mttb-aarhustech/Motorcontrol_PCB/README.md

# Motorcontrol_PCB
Motorcontrol PCB AARHUS TECH
