mttb-aarhustech/Motorcontrol_PCB/Pins.txt

P1A			BC	RC2	
P1B			BC	RB2	
P1C			BC	RB1
P1D			BC	RB4

PGC			RB6	RB6
PGD			RB7	RB7
~MCLR			E	RE3

SWS	I/O			
SWA	I/O			
SWB	I/O			

AN0	Analog in 		
Vref-	RA2			RA2

T1CLK			AC	RC0

RX1			BC	RC7 -> RC6	x	
TX1			BC	RC6 -> RC7	x
BOOT	I/O			

DISP	I/O
SDO1			BC	RC5
SCK1			BC	RC3

SDA (i2c)		BC
SCL (i2c)		BC

SDO2			BC	
SDI2			BC
SCK2			BC
SS2			A

Fri

Icons
0xe,0x11,0x13,0x15,0x19,0x11,0xe,0x1f	0
0x4,0xc,0x4,0x4,0x4,0x4,0xe,0x1f	1
