mttb-aarhustech/Motorcontrol_PCB/Bom.xlsx

Sheet: BOM
Reference | Value | Qty | Supplier | Part number | Column1
Q111,Q113,Q121,Q123,Q132,Q142 | BC557 | 6 | Cypax | 01.020.0557 | 1
Q112,Q122,Q131,Q141,Q210,Q220,Q230,Q240 | BC547 | 8 | Farnell | 1574381 | 2
U901 | L78L05 | 1 | RS | 885-5423 | 3
C110,C120 | 2.2uF | 2 | Farnell | 8766797 | 4
J410 | Conn_01x06_Pin | 1 | - | - | 15
F1 | Fuse | 1 | Cypax | 18.099.0078.10 | 15
R403 | 100R | 1 | Cypax | 05.000.0510 | 15
R901 | 390 | 1 | Cypax | 05.000.0339 | 15
R902 | 68R | 1 | Cypax | 05.000.0268 | 15
C900 | 220uF | 1 | Farnell | 3254121 | 15
DS300 | WC1602A | 1 | Farnell | 1218634 | 15
J411 | USB_B | 1 | Farnell | 1076666 | 15
U410 | MCP2221AxP | 1 | Farnell | 2678459 | 15
U902 | HCPL7510 | 1 | Farnell | 1085055 | 15
J1,J4,J5,J6 | Conn_01x02_Socket | 1 | RS | 252-5139 | 15
J400 | Conn_01x05_Socket | 1 | RS | 233-9362 | 15
J401 | Conn_01x04_Socket | 1 | RS | 233-9354 | 15
L410 | Ferrite_Small | 1 | RS | 467-3315 | 15
R000 | 0R20 | 1 | RS | 846-9836 | 15
R301 | 20k | 1 | RS | 167-3259 | 15
SW310 | RotaryEncoder_Switch_MP | 1 | RS | 781-6830 | 15
U300 | 74AHC595 | 1 | RS | 100-0763 | 15
U400 | PIC18F27Q43-xSP | 1 | RS | 236-8940 | 15
U900 | LM317 | 1 | RS | 168-8786 | 15
 | Conn_01x04_Plug | 1 | RS | 252-5150 | 15
 | Conn_01x06_Socket | 1 | RS | 252-5144 | 15
 | Dil socket 28 pin | 1 | RS | 183-1570 | 15
 | Dil socket 16 pin | 1 | RS | 183-1561 | 15
 | Dil socket 14 pin | 1 | RS | 183-1562 | 15
 | Dil socket 8 pin | 1 | RS | 183-1560 | 15
R111,R121 | 47k | 2 | Cypax | 05.000.0547 | 30
R131,R141 | 270k | 2 | Cypax | 05.000.0627 | 30
R900,R903 | 3k3 | 2 | Cypax | 05.000.0433 | 30
C901,C902 | 10uF | 2 | Farnell | 2901339 | 30
 | Conn_01x02_Plug | 2 | RS | 252-5148 | 30
R110,R120,R130,R140 | 10R | 4 | Cypax | 05.000.0210 | 60
R112,R122,R132,R142 | 150R | 4 | Cypax | 05.000.0315 | 60
R210,R220,R230,R240 | 180 | 4 | Cypax | 05.000.0318 | 60
Q110,Q120,Q130,Q140 | IRLZ44N | 4 | Farnell | 8651418 | 60
U210,U220,U230,U240 | 4N35 | 4 | Farnell | 1021351 | 60
 | Dil socket 6 pin | 4 | RS | 702-0657 | 60
R211,R221,R231,R241,R251,R300,R310,R311,R312,R400,R401,R402,R410 | 10k | 13 | Cypax | 05.000.0510 | 195
R113,R114,R123,R124,R133,R143,R212,R222,R232,R242,R250,R313,R314,R315 | 1k | 14 | Cypax | 05.000.0410 | 210
Q112,Q122,Q131,Q141,Q210,Q220,Q230,Q240 | BC547 | 0 | Cypax | 01.020.0547
U400 | PIC18F27Q43-xSP | 0 | Farnell | 3052751
U410 | MCP2221AxP | 0 | RS | 171-7757
D110,D120,D900,D901 | 1N4148 | 4 | Cypax | 00.001.4148
C250,C300,C310,C311,C312,C400,C401,C411,C903,C904,C906,C907 | 100nF | ~12 | RS | 135-8304
C410 | 470nF | 1 | RS | 172-5820
C905 | 10nF | 1 | RS | 134-5708

Sheet: Sheet1
J401 |  | Conn_01x04_Socket | L410 |  | Ferrite_Small | R000 |  | 0R20
RS | 233-9354 |  | RS | 467-3315 |  | RS | 846-9836
SW310 |  | RotaryEncoder_Switch_MP | U300 |  | 74AHC595 | U900 |  | 10nF
RS | 781-6830 |  | RS | 100-0763 |  | RS | 134-5708
 |  | MCP2221AxP | U902 |  | 470nF |  |  | 100nF
RS | 171-7757 |  | RS | 172-5820 |  | RS | 135-8304
R210,R220,R230,R240 |  | 1N4148 |  |  | Dil socket 6 pin | R211,R221,R231,R241,R251,R300,R310,R311,R312,R400,R401,R402,R410 |  | 10k
Cypax | 00.001.4148 |  | RS | 702-0657 |  | Cypax | 05.000.0510
C901,C902 |  | Ferrite Small | R112,R122,R132,R142 |  | Rotary Encoder | PIC18F27Q43-xSP
Cypax | 05.000.0433 |  | Cypax | 05.000.0315 |  | Farnell | 3052751
47k |  |  | R131,R141 |  | Conn_01x05 Socket | R900,R903 |  | Conn_01x04 Socket
Cypax | 05.000.0547 |  | Cypax | 05.000.0627 |  | Cypax | 05.000.0433
