mttb-aarhustech/Motorcontrol_PCB/Motor Control.xlsx

Reference | Value | Qty | Supplier | Part number
F1 | Fuse | 1
J1,J4,J5,J6 | Conn_01x02_Socket | 4
J410 | Conn_01x06_Pin | 1
D110,D120,D900,D901 | 1N4148 | 4 | Cypax | 00.001.4148
Q111,Q113,Q121,Q123,Q132,Q142 | BC557 | 6 | Cypax | 01.020.0557
Q112,Q122,Q131,Q141,Q210,Q220,Q230,Q240 | BC547 | 8 | Cypax | 01.020.0547
R110,R120,R130,R140 | 10R | 4 | Cypax | 05.000.0210
R111,R121 | 47k | 2 | Cypax | 05.000.0547
R112,R122,R132,R142 | 150 | 4 | Cypax | 05.000.0315
R113,R114,R123,R124,R133,R143,R212,R222,R232,R242,R250,R313,R314,R315 | 1k | 14 | Cypax | 05.000.0410
R131,R141 | 270k | 2 | Cypax | 05.000.0627
R210,R220,R230,R240 | 180 | 4 | Cypax | 05.000.0318
R211,R221,R231,R241,R251,R310,R311,R312,R400,R401,R410 | 10k | 11 | Cypax | 05.000.0510
R900,R903 | 3k3 | 2 | Cypax | 05.000.0433
R901 | 390 | 1 | Cypax | 05.000.0339
R902 | 68R | 1 | Cypax | 05.000.0268
C110,C120 | 2.2uF | 2 | Farnell | 8766797
C900 | 220uF | 1 | Farnell | 3254121
C901,C902 | 10uF | 2 | Farnell | 2901339
DS300 | WC1602A | 1 | Farnell | 1218634
J411 | USB_B | 1 | Farnell | 1076666
Q110,Q120,Q130,Q140 | IRLZ44N | 4 | Farnell | 8651418
U210,U220,U230,U240 | 4N35 | 4 | Farnell | 1021351
U902 | HCPL7510 | 1 | Farnell | 1085055
C250,C300,C310,C311,C312,C400,C411,C903,C904,C906,C907 | 100nF | 11 | RS | 135-8304
C410 | 470nF | 1 | RS | 172-5820
C905 | 10nF | 1 | RS | 134-5708
J400 | Conn_01x05_Pin | 1 | RS | 233-9362
L410 | L_Ferrite_Small | 1 | RS | 467-3315
R000 | 0R20 | 1 | RS | 846-9836
R300 | 20k | 1 | RS | 167-3259
SW310 | RotaryEncoder_Switch_MP | 1 | RS | 781-6830
U300 | 74AHC595 | 1 | RS | 100-0763
U400 | PIC18F26K22-xSP | 1 | RS | 887-7252
U410 | MCP2221AxP | 1 | RS | 171-7757
U900 | LM317 | 1 | RS | 168-8786
U901 | L78L05 | 1 | RS | 885-5423
DIL fatninger
6 pin |  | 4 | RS | 813-109
8 pin |  | 1 | RS | 183-1560
14 pin |  | 1 | RS | 183-1562
16 pin |  | 1 | RS | 183-1561
28 pin |  | 1 | RS | 183-1570
Afstandsstykke |  | 4 | RS | 205-2945
Skrue |  | 4 | RS | 526-912
Møtrik |  | 4 | RS | 490-931
