mttb-aarhustech/Motorcontrol_PCB/Motor Control.pdf

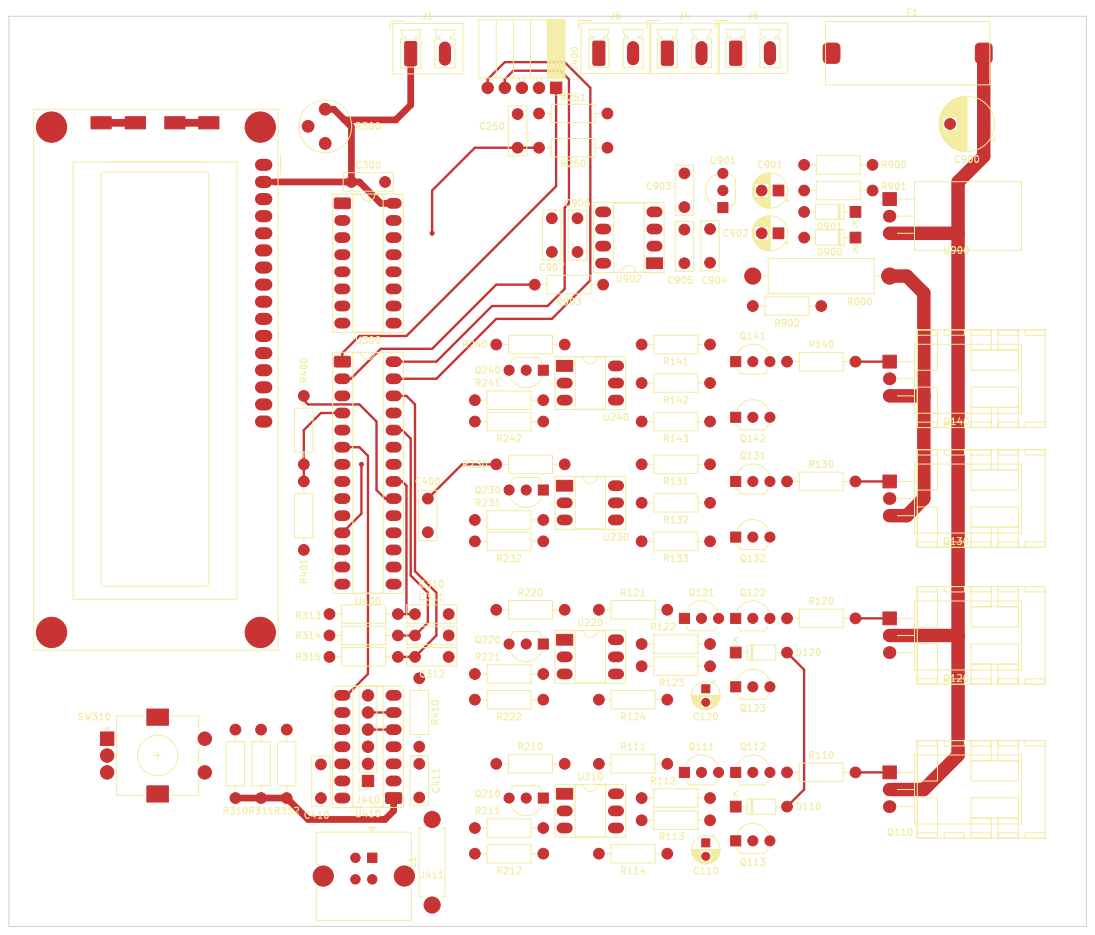
[picture p2: page 1]

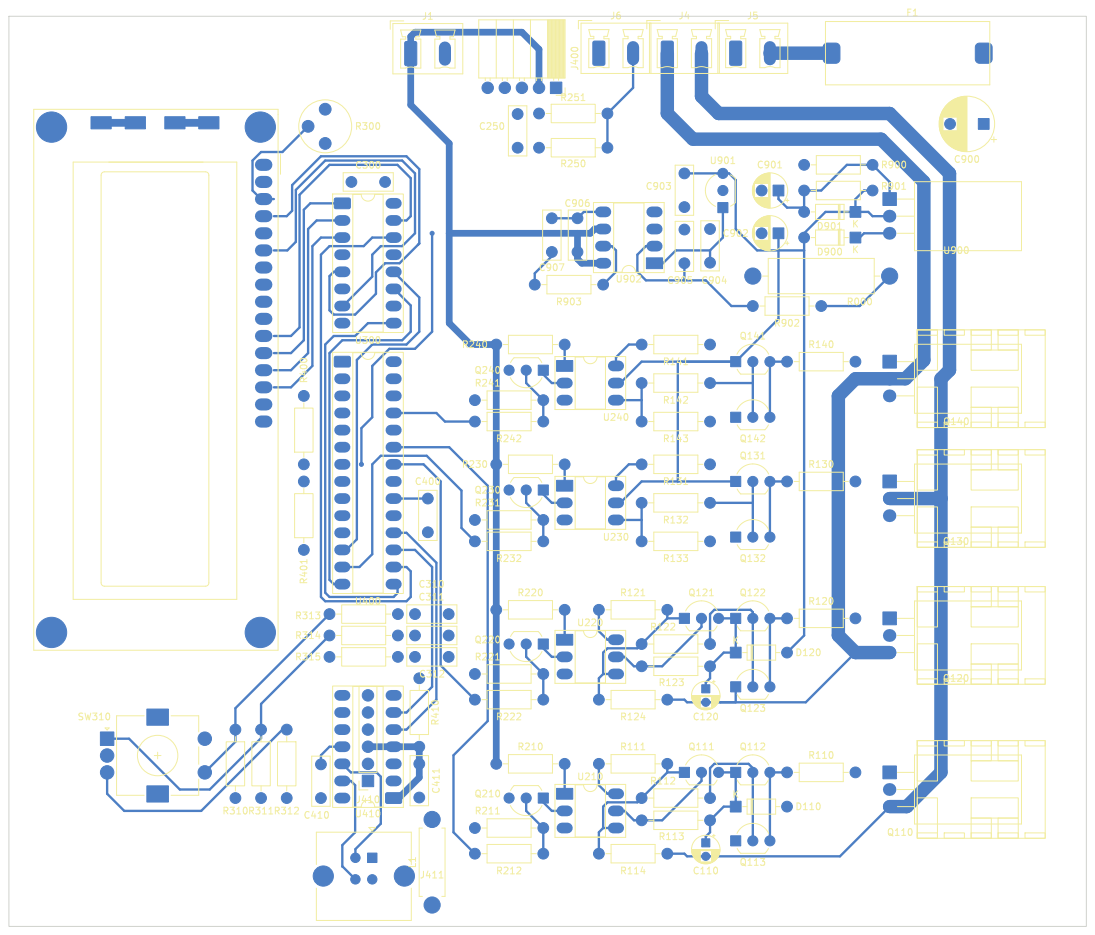
[picture p3: page 2]
