mttb-aarhustech/Motorcontrol_PCB/H_bridge/Motor Control-H Bridge.pdf

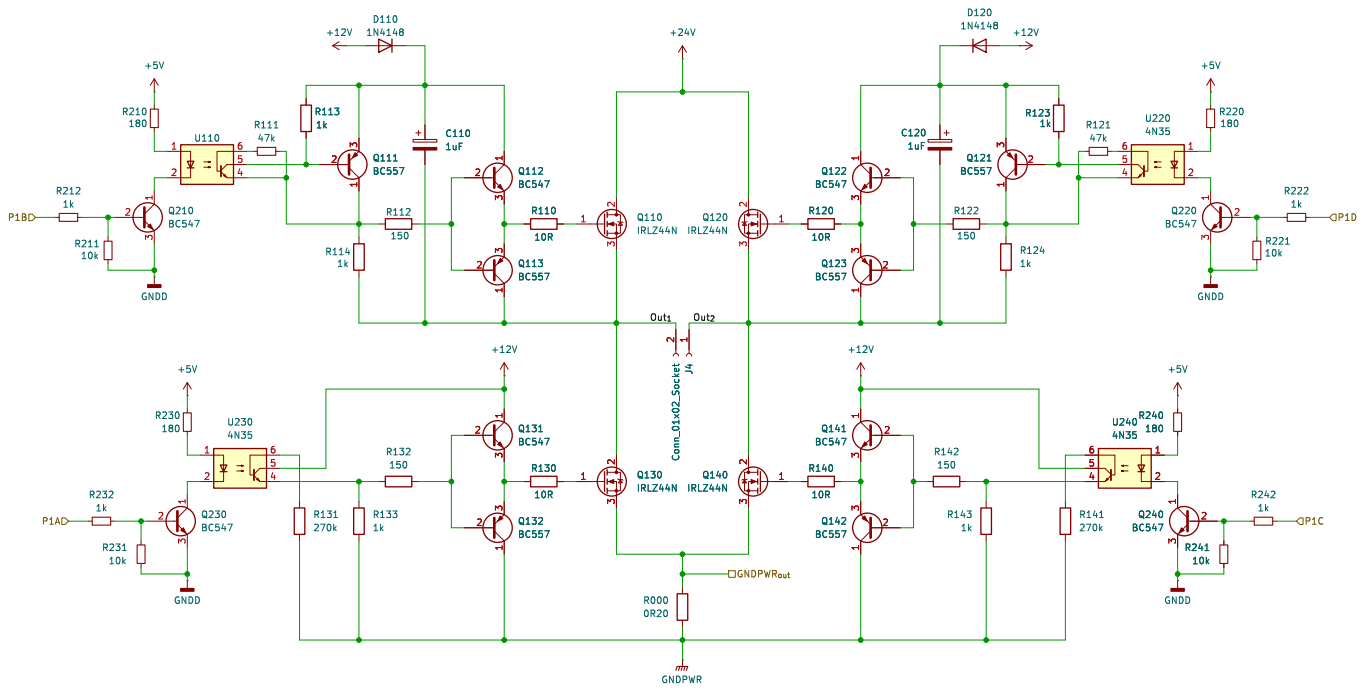
[picture p4: page 1]
