mttb-aarhustech/Motorcontrol_PCB/Motor Control.kicad_pcb

## KiCad design Motor Control.kicad_pcb (2025-12-16)

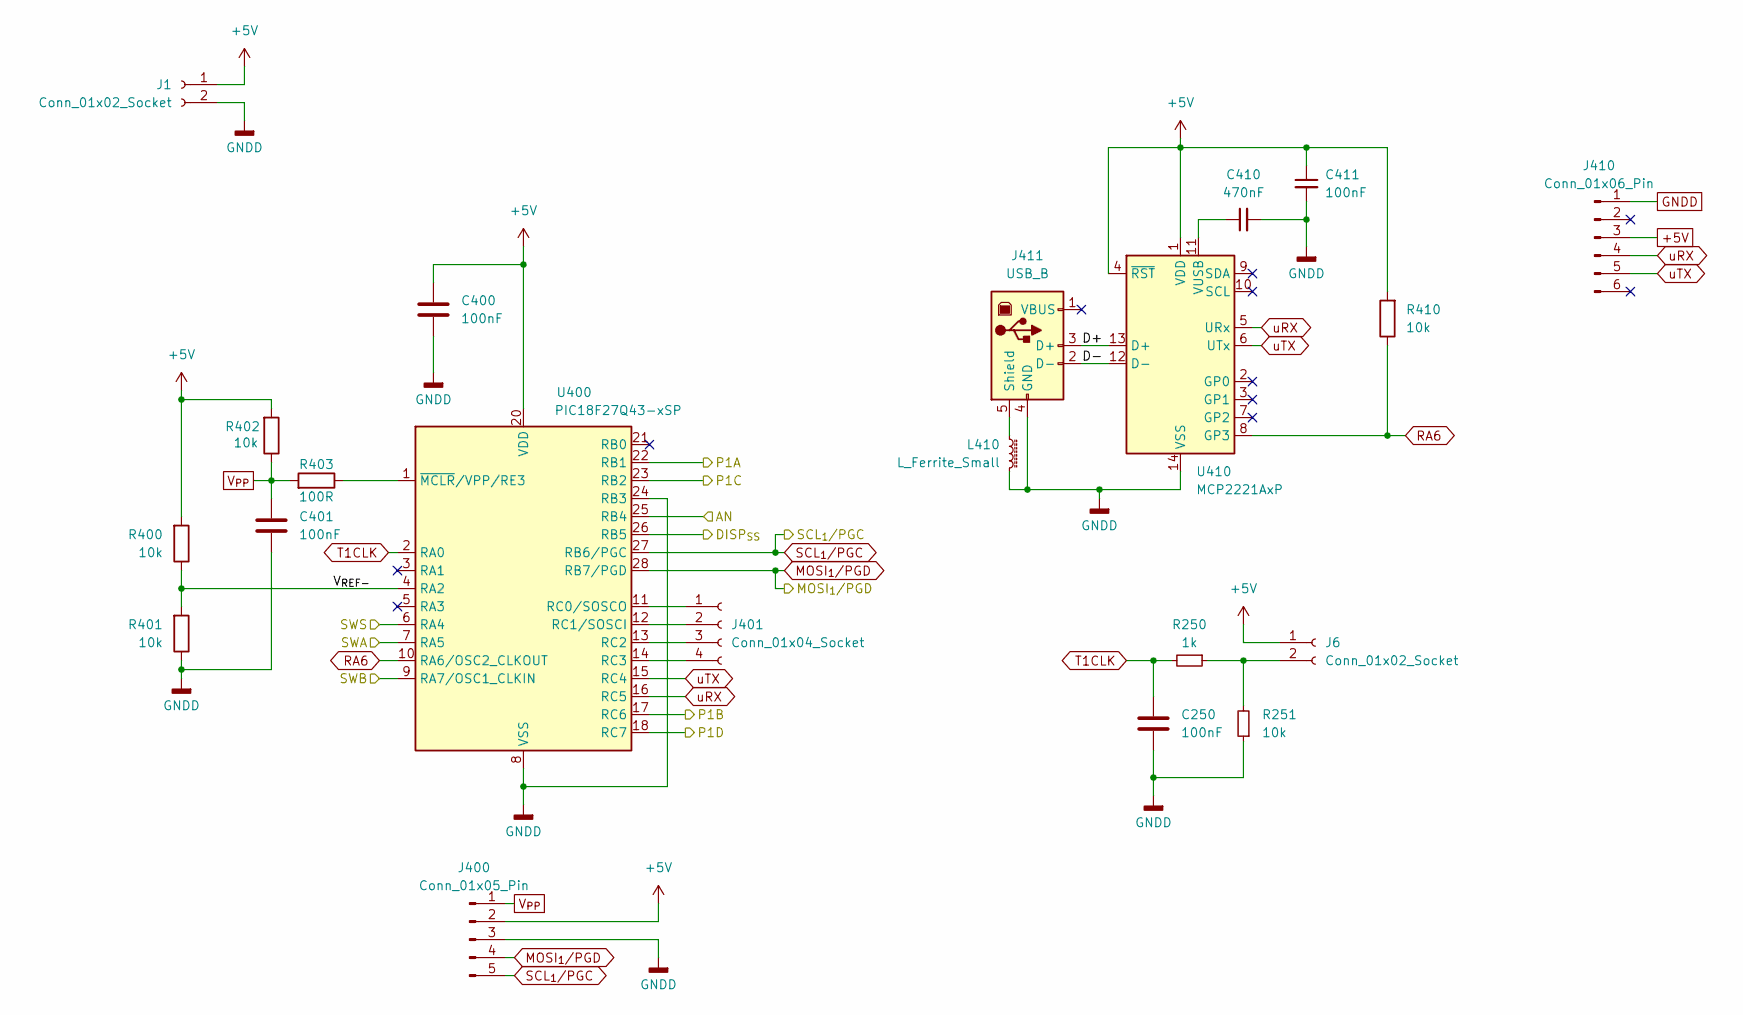
[picture p5: schematic MCU_USB.kicad_sch, Motor Control]

Parts:
C250, C400, C401, C411: 100nF; C_Rect_L7.2mm_W2.5mm_P5.00mm_FKS2_FKP2_MKS2_MKP2; Part number 135-8304
C410: 470nF; C_Rect_L7.2mm_W2.5mm_P5.00mm_FKS2_FKP2_MKS2_MKP2; Part number 172-5820
J1, J6: Conn_01x02_Socket; PhoenixContact_MCV_1,5_2-G-5.08_1x02_P5.08mm_Vertical
J400: Conn_01x05_Pin; PinSocket_1x05_P2.54mm_Horizontal; Part number 233-9362
J401: Conn_01x04_Socket; PinSocket_1x04_P2.54mm_Horizontal
J410: Conn_01x06_Pin; PinSocket_1x06_P2.54mm_Vertical
J411: USB_B; USB_B_TE_5787834_Vertical; Part number 1076666
L410: L_Ferrite_Small; R_Axial_DIN0411_L9.9mm_D3.6mm_P12.70mm_Horizontal; Part number 467-3315
R250: 1k; R_Axial_DIN0207_L6.3mm_D2.5mm_P10.16mm_Horizontal; Part number 05.000.0410
R251, R400, R401, R402, R410: 10k; R_Axial_DIN0207_L6.3mm_D2.5mm_P10.16mm_Horizontal; Part number 05.000.0510
R403: 100R; R_Axial_DIN0207_L6.3mm_D2.5mm_P10.16mm_Horizontal; Part number 05.000.0510
U400: PIC18F27Q43-xSP; DIP-28_W7.62mm_Socket_LongPads
U410: MCP2221AxP; DIP-14_W7.62mm_Socket_LongPads; Part number 171-7757

Connections:
+5V: C400.1, C411.1, J1.1, J6.1, J400.2, J410.3, R400.2, R402.2, R410.2, U400.20 (VDD), U410.1 (VDD), U410.4 (~RST); also elsewhere on the board
/Disp & encoder/DISP_{SS}: U400.26 (RB5); also elsewhere on the board
/Disp & encoder/SWA: U400.7 (RA5); also elsewhere on the board
/Disp & encoder/SWB: U400.9 (RA7/OSC1_CLKIN); also elsewhere on the board
/Disp & encoder/SWS: U400.6 (RA4); also elsewhere on the board
/H Bridge/P1A: U400.22 (RB1); also elsewhere on the board
/H Bridge/P1B: U400.17 (RC6); also elsewhere on the board
/H Bridge/P1C: U400.23 (RB2); also elsewhere on the board
/H Bridge/P1D: U400.18 (RC7); also elsewhere on the board
/MCU & USB/AN: U400.25 (RB4); also elsewhere on the board
/MCU & USB/D+: J411.3 (D+), U410.13 (D+)
/MCU & USB/D-: J411.2 (D-), U410.12 (D-)
/MCU & USB/V_{REF-}: R400.1, R401.2, U400.4 (RA2)
GNDD: C250.2, C400.2, C401.2, C410.2, C411.2, J1.2, J400.3, J410.1, J411.4 (GND), L410.2, R251.1, R401.1, U400.8 (VSS), U400.19 (VSS), U400.24 (RB3), U410.14 (VSS); also elsewhere on the board
MOSI_{1}/PGD: J400.4, U400.28 (RB7/PGD); also elsewhere on the board
unnamed: J6.2, R250.1, R251.2
unnamed: J401.1, U400.11 (RC0/SOSCO)
unnamed: J401.2, U400.12 (RC1/SOSCI)
unnamed: J401.3, U400.13 (RC2)
unnamed: J401.4, U400.14 (RC3)
unnamed: J411.5 (Shield), L410.1
unnamed: R403.1, U400.1 (~MCLR/VPP/RE3)
unnamed: C410.1, U410.11 (VUSB)
RA6: R410.1, U400.10 (RA6/OSC2_CLKOUT), U410.8 (GP3)
SCL_{1}/PGC: J400.5, U400.27 (RB6/PGC); also elsewhere on the board
T1CLK: C250.1, R250.2, U400.2 (RA0)
V_{PP}: C401.1, J400.1, R402.1, R403.2
uRX: J410.4, U400.16 (RC5), U410.5 (URx)
uTX: J410.5, U400.15 (RC4), U410.6 (UTx)

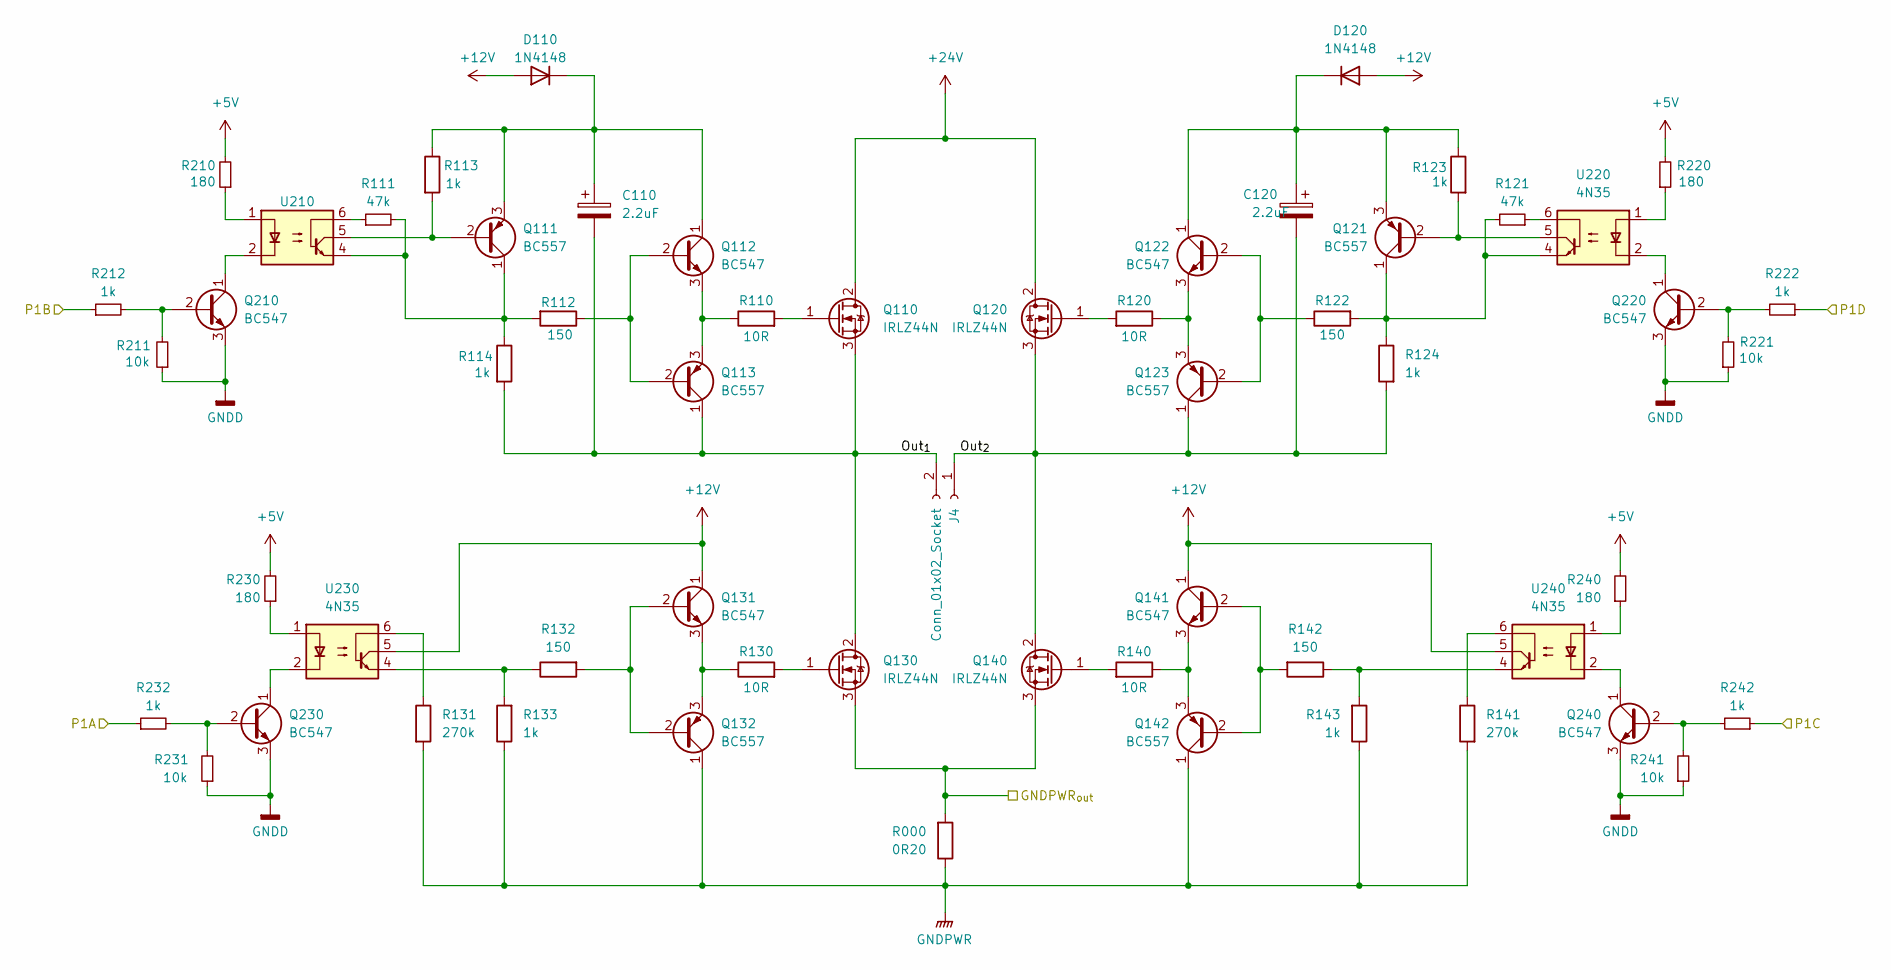
[picture p6: schematic H Bridge.kicad_sch, Motor Control]

Parts:
C110, C120: 2.2uF; CP_Radial_D4.0mm_P2.00mm; Part number 8766797
D110, D120: 1N4148; D_DO-35_SOD27_P7.62mm_Horizontal; Part number 00.001.4148
J4: Conn_01x02_Socket; PhoenixContact_MCV_1,5_2-G-5.08_1x02_P5.08mm_Vertical
Q110, Q120, Q130, Q140: IRLZ44N; TO-220-3_Horizontal_TabDown_HoleToCenter; Part number 8651418
Q111, Q113, Q121, Q123, Q132, Q142: BC557; TO-92_Inline_Wide; Part number 01.020.0557
Q112, Q122, Q131, Q141, Q210, Q220, Q230, Q240: BC547; TO-92_Inline_Wide; Part number 01.020.0547
R000: 0R20; R_Axial_DIN0516_L15.5mm_D5.0mm_P20.32mm_Horizontal; Part number 846-9836
R110, R120, R130, R140: 10R; R_Axial_DIN0207_L6.3mm_D2.5mm_P10.16mm_Horizontal; Part number 05.000.0210
R111, R121: 47k; R_Axial_DIN0207_L6.3mm_D2.5mm_P10.16mm_Horizontal; Part number 05.000.0547
R112, R122, R132, R142: 150; R_Axial_DIN0207_L6.3mm_D2.5mm_P10.16mm_Horizontal; Part number 05.000.0315
R113, R114, R123, R124, R133, R143, R212, R222, R232, R242: 1k; R_Axial_DIN0207_L6.3mm_D2.5mm_P10.16mm_Horizontal; Part number 05.000.0410
R131, R141: 270k; R_Axial_DIN0207_L6.3mm_D2.5mm_P10.16mm_Horizontal; Part number 05.000.0627
R210, R220, R230, R240: 180; R_Axial_DIN0207_L6.3mm_D2.5mm_P10.16mm_Horizontal; Part number 05.000.0318
R211, R221, R231, R241: 10k; R_Axial_DIN0207_L6.3mm_D2.5mm_P10.16mm_Horizontal; Part number 05.000.0510
U210, U220, U230, U240: 4N35; DIP-6_W7.62mm_Socket_LongPads; Part number 1021351

Connections:
+5V: R210.2, R220.2, R230.2, R240.2; also elsewhere on the board
+12V: D110.2 (A), D120.2 (A), Q131.1 (C), Q141.1 (C), U230.5, U240.5; also elsewhere on the board
+24V: Q110.2 (D), Q120.2 (D); also elsewhere on the board
/H Bridge/GNDPWR_{out}: Q130.3 (S), Q140.3 (S), R000.2; also elsewhere on the board
/H Bridge/Out_{1}: C110.2, J4.2, Q110.3 (S), Q113.1 (C), Q130.2 (D), R114.2
/H Bridge/Out_{2}: C120.2, J4.1, Q120.3 (S), Q123.1 (C), Q140.2 (D), R124.2
/H Bridge/P1A: R232.1; also elsewhere on the board
/H Bridge/P1B: R212.1; also elsewhere on the board
/H Bridge/P1C: R242.1; also elsewhere on the board
/H Bridge/P1D: R222.1; also elsewhere on the board
GNDD: Q210.3 (E), Q220.3 (E), Q230.3 (E), Q240.3 (E), R211.1, R221.1, R231.1, R241.1; also elsewhere on the board
GNDPWR: Q132.1 (C), Q142.1 (C), R000.1, R131.2, R133.1, R141.2, R143.1; also elsewhere on the board
unnamed: C110.1, D110.1 (K), Q111.3 (E), Q112.1 (C), R113.1
unnamed: C120.1, D120.1 (K), Q121.3 (E), Q122.1 (C), R123.1
unnamed: Q110.1 (G), R110.2
unnamed: Q111.2 (B), R113.2, U210.5
unnamed: Q111.1 (C), R111.2, R112.2, R114.1, U210.4
unnamed: Q112.2 (B), Q113.2 (B), R112.1
unnamed: Q112.3 (E), Q113.3 (E), R110.1
unnamed: Q120.1 (G), R120.2
unnamed: Q121.2 (B), R123.2, U220.5
unnamed: Q121.1 (C), R121.2, R122.2, R124.1, U220.4
unnamed: Q122.2 (B), Q123.2 (B), R122.1
unnamed: Q122.3 (E), Q123.3 (E), R120.1
unnamed: Q130.1 (G), R130.2
unnamed: Q131.2 (B), Q132.2 (B), R132.2
unnamed: Q131.3 (E), Q132.3 (E), R130.1
unnamed: Q140.1 (G), R140.2
unnamed: Q141.2 (B), Q142.2 (B), R142.2
unnamed: Q141.3 (E), Q142.3 (E), R140.1
unnamed: Q210.2 (B), R211.2, R212.2
unnamed: Q210.1 (C), U210.2
unnamed: Q220.2 (B), R221.2, R222.2
unnamed: Q220.1 (C), U220.2
unnamed: Q230.2 (B), R231.2, R232.2
unnamed: Q230.1 (C), U230.2
unnamed: Q240.2 (B), R241.2, R242.2
unnamed: Q240.1 (C), U240.2
unnamed: R111.1, U210.6
unnamed: R121.1, U220.6
unnamed: R131.1, U230.6
unnamed: R132.1, R133.2, U230.4
unnamed: R141.1, U240.6
unnamed: R142.1, R143.2, U240.4
unnamed: R210.1, U210.1
unnamed: R220.1, U220.1
unnamed: R230.1, U230.1
unnamed: R240.1, U240.1

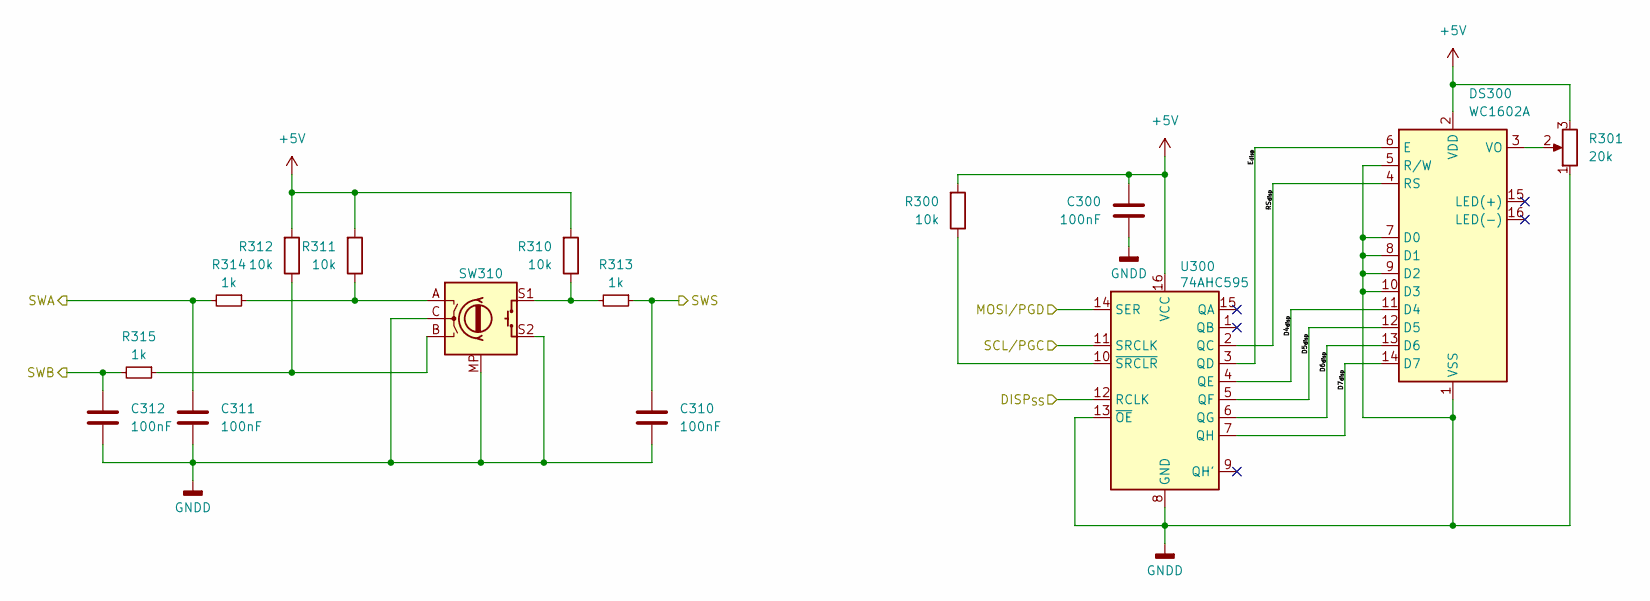
[picture p7: schematic dispEncoder.kicad_sch, Motor Control]

Parts:
C300, C310, C311, C312: 100nF; C_Rect_L7.2mm_W2.5mm_P5.00mm_FKS2_FKP2_MKS2_MKP2; Part number 135-8304
DS300: WC1602A; Powertip_PC1602; Part number 1218634
R300, R310, R311, R312: 10k; R_Axial_DIN0207_L6.3mm_D2.5mm_P10.16mm_Horizontal; Part number 05.000.0510
R301: 20k; Potentiometer_Bourns_3339P_Vertical_HandSoldering; Part number 167-3259
R313, R314, R315: 1k; R_Axial_DIN0207_L6.3mm_D2.5mm_P10.16mm_Horizontal; Part number 05.000.0410
SW310: RotaryEncoder_Switch_MP; RotaryEncoder_Bourns-Switch_Vertical_H20mm; Part number 781-6830
U300: 74AHC595; DIP-16_W7.62mm_Socket_LongPads; Part number 100-0763

Connections:
+5V: C300.1, DS300.2 (VDD), R300.2, R301.3, R310.2, R311.2, R312.2, U300.16 (VCC); also elsewhere on the board
/Disp & encoder/D4_{disp}: DS300.11 (D4), U300.4 (QE)
/Disp & encoder/D5_{disp}: DS300.12 (D5), U300.5 (QF)
/Disp & encoder/D6_{disp}: DS300.13 (D6), U300.6 (QG)
/Disp & encoder/D7_{disp}: DS300.14 (D7), U300.7 (QH)
/Disp & encoder/DISP_{SS}: U300.12 (RCLK); also elsewhere on the board
/Disp & encoder/E_{disp}: DS300.6 (E), U300.3 (QD)
/Disp & encoder/RS_{disp}: DS300.4 (RS), U300.2 (QC)
/Disp & encoder/SWA: C311.1, R314.2; also elsewhere on the board
/Disp & encoder/SWB: C312.1, R315.2; also elsewhere on the board
/Disp & encoder/SWS: C310.1, R313.1; also elsewhere on the board
GNDD: C300.2, C310.2, C311.2, C312.2, DS300.1 (VSS), DS300.5 (R/W), DS300.7 (D0), DS300.8 (D1), DS300.9 (D2), DS300.10 (D3), R301.1, SW310.C, SW310.MP, SW310.S2, U300.8 (GND), U300.13 (~OE); also elsewhere on the board
MOSI_{1}/PGD: U300.14 (SER); also elsewhere on the board
unnamed: DS300.3 (VO), R301.2
unnamed: R310.1, R313.2, SW310.S1
unnamed: R311.1, R314.1, SW310.A
unnamed: R312.1, R315.1, SW310.B
unnamed: R300.1, U300.10 (~SRCLR)
SCL_{1}/PGC: U300.11 (SRCLK); also elsewhere on the board

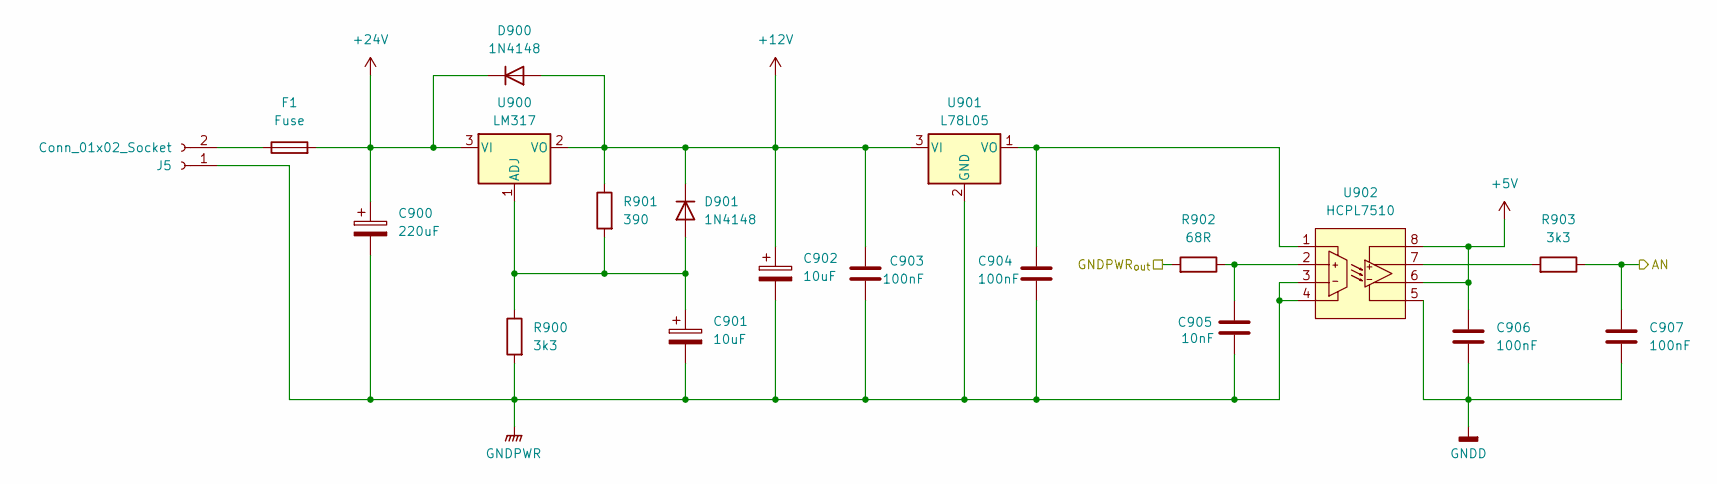
[picture p8: schematic PSU.kicad_sch, Motor Control]

Parts:
C900: 220uF; CP_Radial_D8.0mm_P5.00mm; Part number 3254121
C901, C902: 10uF; CP_Radial_D5.0mm_P2.50mm; Part number 2901339
C903, C904, C906, C907: 100nF; C_Rect_L7.2mm_W2.5mm_P5.00mm_FKS2_FKP2_MKS2_MKP2; Part number 135-8304
C905: 10nF; C_Rect_L7.2mm_W2.5mm_P5.00mm_FKS2_FKP2_MKS2_MKP2; Part number 134-5708
D900, D901: 1N4148; D_DO-35_SOD27_P7.62mm_Horizontal; Part number 00.001.4148
F1: Fuse; Fuseholder_Stelvio-kontek_PTF_78_5x20mm
J5: Conn_01x02_Socket; PhoenixContact_MCV_1,5_2-G-5.08_1x02_P5.08mm_Vertical
R900, R903: 3k3; R_Axial_DIN0207_L6.3mm_D2.5mm_P10.16mm_Horizontal; Part number 05.000.0433
R901: 390; R_Axial_DIN0207_L6.3mm_D2.5mm_P10.16mm_Horizontal; Part number 05.000.0339
R902: 68R; R_Axial_DIN0207_L6.3mm_D2.5mm_P10.16mm_Horizontal; Part number 05.000.0268
U900: LM317; TO-220-3_Horizontal_TabDown_HoleToCenter; Part number 168-8786
U901: L78L05; TO-92_Inline_Wide; Part number 885-5423
U902: HCPL7510; DIP-8_W7.62mm_Socket_LongPads; Part number 1085055

Connections:
+5V: C906.1, U902.6 (V_{REF}), U902.8 (V_{DD2}); also elsewhere on the board
+12V: C902.1, C903.1, D900.2 (A), D901.1 (K), R901.1, U900.2 (VO), U901.3 (VI); also elsewhere on the board
+24V: C900.1, D900.1 (K), F1.2, U900.3 (VI); also elsewhere on the board
/H Bridge/GNDPWR_{out}: R902.2; also elsewhere on the board
/MCU & USB/AN: C907.1, R903.1; also elsewhere on the board
GNDD: C906.2, C907.2, U902.5 (GND_{2}); also elsewhere on the board
GNDPWR: C900.2, C901.2, C902.2, C903.2, C904.2, C905.2, J5.1, R900.2, U901.2 (GND), U902.3 (V_{IN-}), U902.4 (GND_{1}); also elsewhere on the board
unnamed: C901.1, D901.2 (A), R900.1, R901.2, U900.1 (ADJ)
unnamed: F1.1, J5.2
unnamed: C904.1, U901.1 (VO), U902.1 (V_{DD1})
unnamed: C905.1, R902.1, U902.2 (V_{IN+})
unnamed: R903.2, U902.7 (V_{OUT})

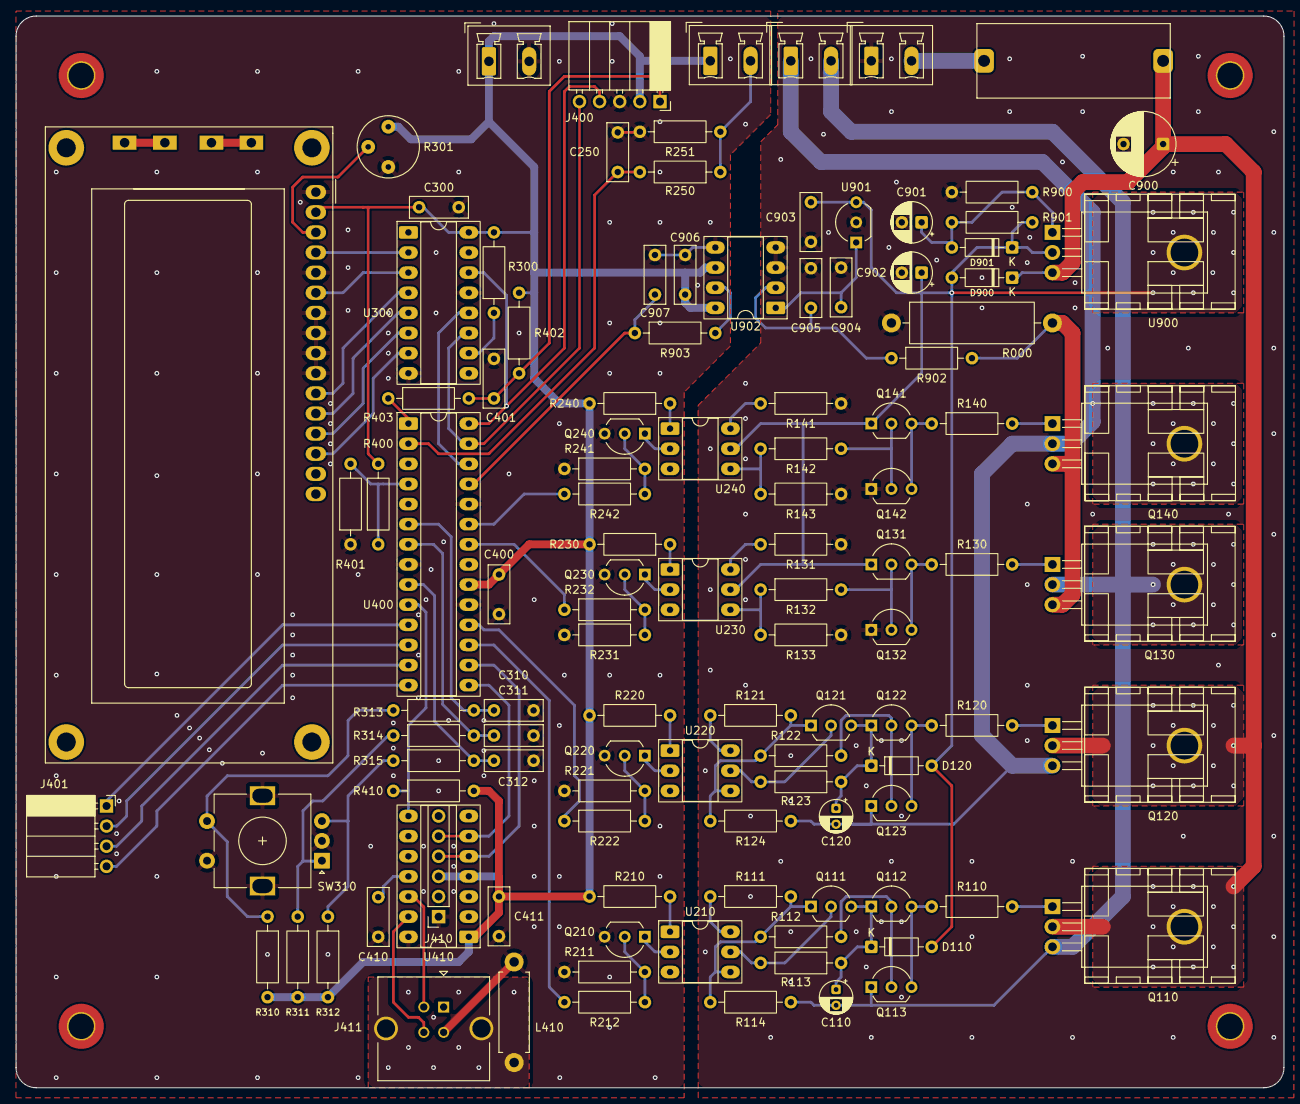
[picture p9: board Motor Control.kicad_pcb from above]

Board: 2 copper layers, 160.0 x 135.3 mm, 113 parts (0 on the bottom side), 87 nets.
