mttb-aarhustech/Motorcontrol_PCB/(commit log)

2025-07-03 Initial Project
    [Motor Control.kicad_pcb, Motor Control.kicad_sch]
2025-07-03 H bridge sch. and pcb blocks done
    H bridge schematic done
    H bridge PCB done
    minor silkscreen correction needed
    [H Bridge.kicad_sch, Motor Control.kicad_pcb, Motor Control.kicad_sch]
2025-07-04 Placement H bridge & PSU
    [H Bridge.kicad_sch, Motor Control.kicad_pcb, Motor Control.kicad_sch, PSU.kicad_sch]
2025-07-06 Update to v 9.0
    [Motor Control.kicad_pcb]
2025-07-09 Update 090725
    New footprints added
    Schematic made into sub schematics
    PCB needs work
    Component references need to be sorted for the most part
    [H Bridge.kicad_sch, MCU_USB.kicad_sch, Motor Control.kicad_pcb, Motor Control.kicad_sch, PSU.kicad_sch, dispEncoder.kicad_sch]
2025-07-12 Almost done
    Schematic done
    PCB missing ground planes
    Need Coopilot review
    [MCU_USB.kicad_sch, Motor Control.kicad_pcb, Motor Control.kicad_sch, dispEncoder.kicad_sch]
2025-07-12 Few changes made
    [Motor Control.kicad_pcb]
2025-07-13 V 1.0 fabrication output
    V 1.0 ready for fabrication
    [H Bridge.kicad_sch, MCU_USB.kicad_sch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]
2025-07-17 V 1.0.1
    Stiched vias under TO 220
    [Motor Control-B_Cu.gbr, Motor Control-B_Mask.gbr, Motor Control-B_Silkscreen.gbr, Motor Control-Edge_Cuts.gbr, Motor Control-F_Cu.gbr, Motor Control-F_Mask.gbr, Motor Control-F_Silkscreen.gbr, Motor Control-NPTH.drl]
2025-07-28 Small update 1.0.1
    [Motor Control.kicad_pcb]
2025-10-20 Update Motor Control.kicad_pro
2025-11-24 V 2.0
    [MCU_USB.kicad_sch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]
2025-12-16 2.0
    Version 2.0 final
    [Bom.xlsx, Motor Control.kicad_pcb]
2026-02-17 README.pdf added
    [Bom.xlsx]
